skafreen2225-ctrl/Smart-Plant-Monitoring-and-Watering-System/README.md

# Smart-Plant-Monitoring-and-Watering-System
ESP32-based Smart Plant Monitoring & Watering System with Automated Irrigation, IoT Monitoring, PCB Design, and CAD Enclosure Design.

## Overview

The Smart Plant Monitoring & Watering System is an ESP32-based IoT solution designed to automate plant care while providing environmental monitoring and interactive user engagement. The system continuously monitors soil moisture, temperature, humidity, and water tank level, automatically watering the plant when required and alerting the user when the water reservoir is low.

In addition to automation, the project incorporates interactive OLED expressions that respond to touch and proximity detection, creating a more engaging user experience. The project also includes a custom PCB designed using EasyEDA and a complete product enclosure designed using Onshape.

## Features

* Automatic plant watering using soil moisture monitoring
* Water tank level monitoring using an ultrasonic sensor
* Low-water buzzer alert system
* Temperature and humidity monitoring using DHT11
* OLED dashboard displaying real-time sensor readings
* Interactive OLED eye expressions
* Touch-based expression changes
* IR-based proximity detection
* IoT monitoring through Blynk
* Custom PCB design using EasyEDA
* Custom enclosure design using Onshape

## Components Used

* ESP32 Development Board
* Soil Moisture Sensor
* DHT11 Temperature and Humidity Sensor
* HC-SR04 Ultrasonic Sensor
* SSD1306 OLED Display
* IR Proximity Sensor
* Touch Sensor
* Relay Module
* Water Pump
* Buzzer
* Logic Level Converter
* Water Reservoir
* Power Supply

## Tools Used
* ESP32
* Arduino IDE
* EasyEDA
* Onshape
* Blynk IoT

## Software and Design Tools

* Arduino IDE
* Blynk IoT Platform
* EasyEDA
* Onshape

## Repository Structure

* Documentation – Project report and supporting documents
* Source_Code – Arduino and Blynk implementations
* PCB_Design – Schematic, PCB layout, 3D view, and Gerber files
* CAD_Design – Enclosure and assembly designs
* Images – Circuit diagrams, PCB screenshots, and CAD renders
* Videos – Demonstration video links

## Future Improvements

* Mobile push notifications
* Solar-powered operation
* AI-based plant health recommendations
* Support for multiple plants
* Battery backup system
