skafreen2225-ctrl/Smart-Plant-Monitoring-and-Watering-System/CAD_Design/Complete_Enclosure .png

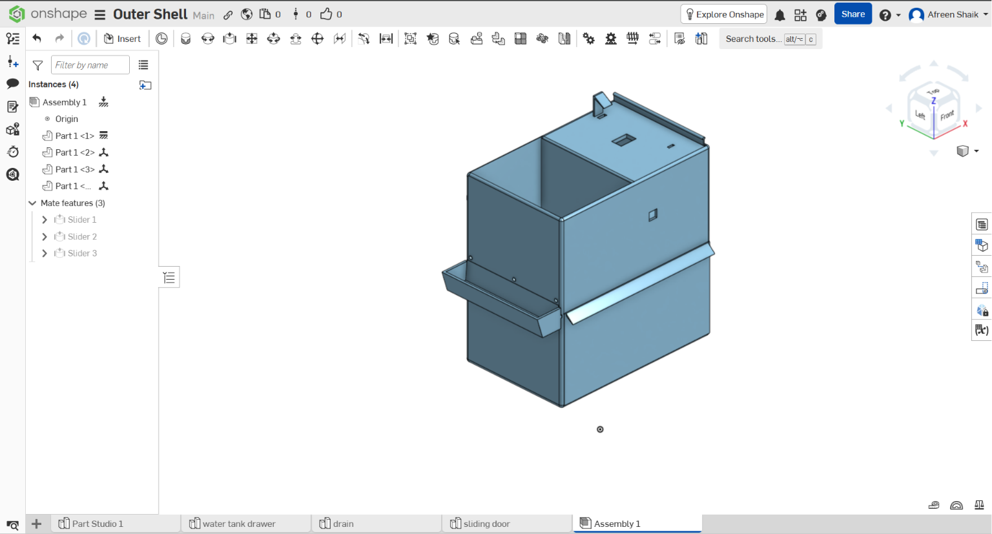
CAD_Design/Complete_Enclosure .png
