skafreen2225-ctrl/Smart-Plant-Monitoring-and-Watering-System/CAD_Design/Drain_Slot_Action.png

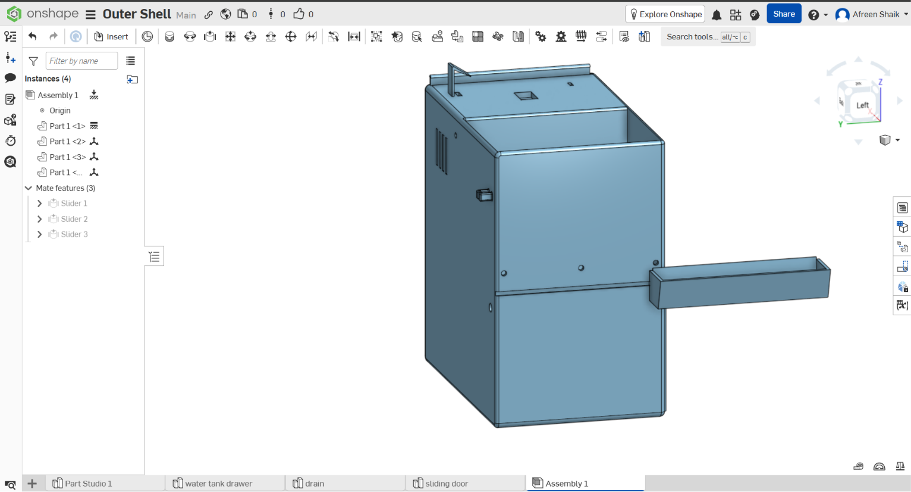
CAD_Design/Drain_Slot_Action.png
