skafreen2225-ctrl/Smart-Plant-Monitoring-and-Watering-System/CAD_Design/Sliding_Door_Action.png

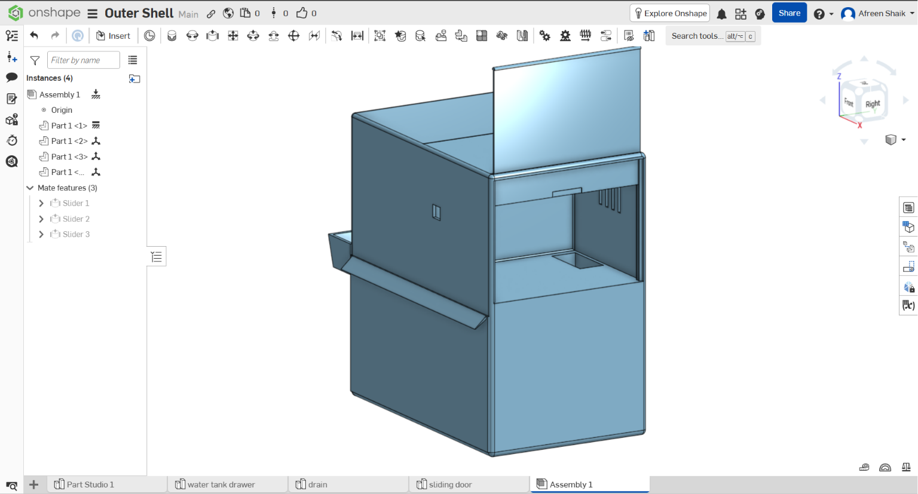
CAD_Design/Sliding_Door_Action.png
