skafreen2225-ctrl/Smart-Plant-Monitoring-and-Watering-System/CAD_Design/Water_Tank_Drawer.png

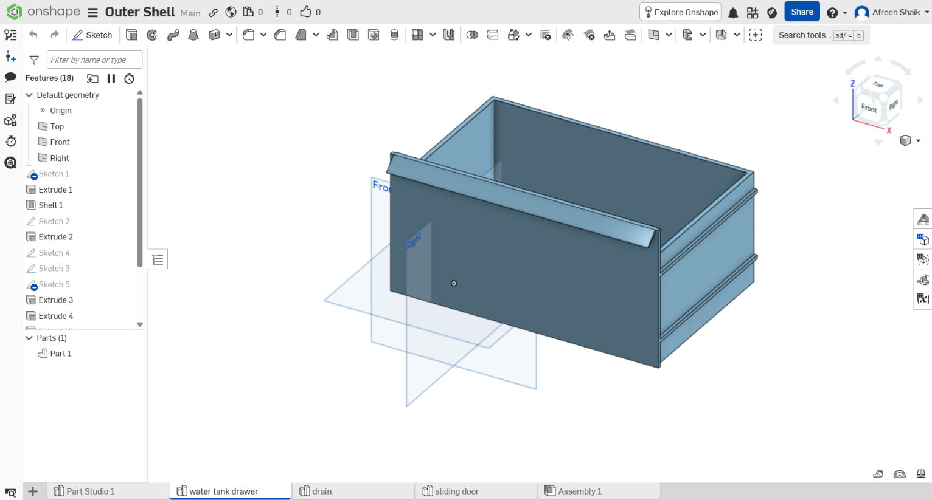
CAD_Design/Water_Tank_Drawer.png
