skafreen2225-ctrl/Smart-Plant-Monitoring-and-Watering-System/PCB_Design/PCB_PCB_smart_plant_watering_system_Top_layer.png

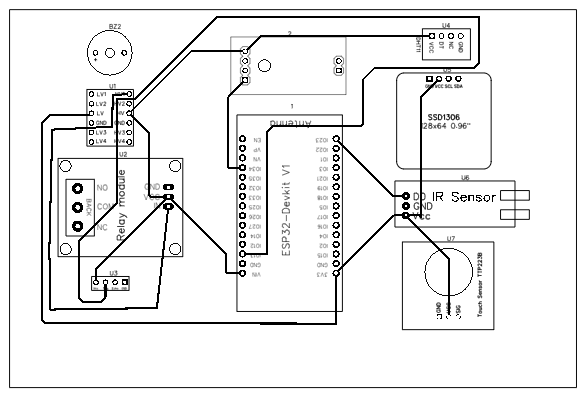
PCB_Design/PCB_PCB_smart_plant_watering_system_Top_layer.png
