skafreen2225-ctrl/Smart-Plant-Monitoring-and-Watering-System/PCB_Design/Schematic_smart_plant_watering.png

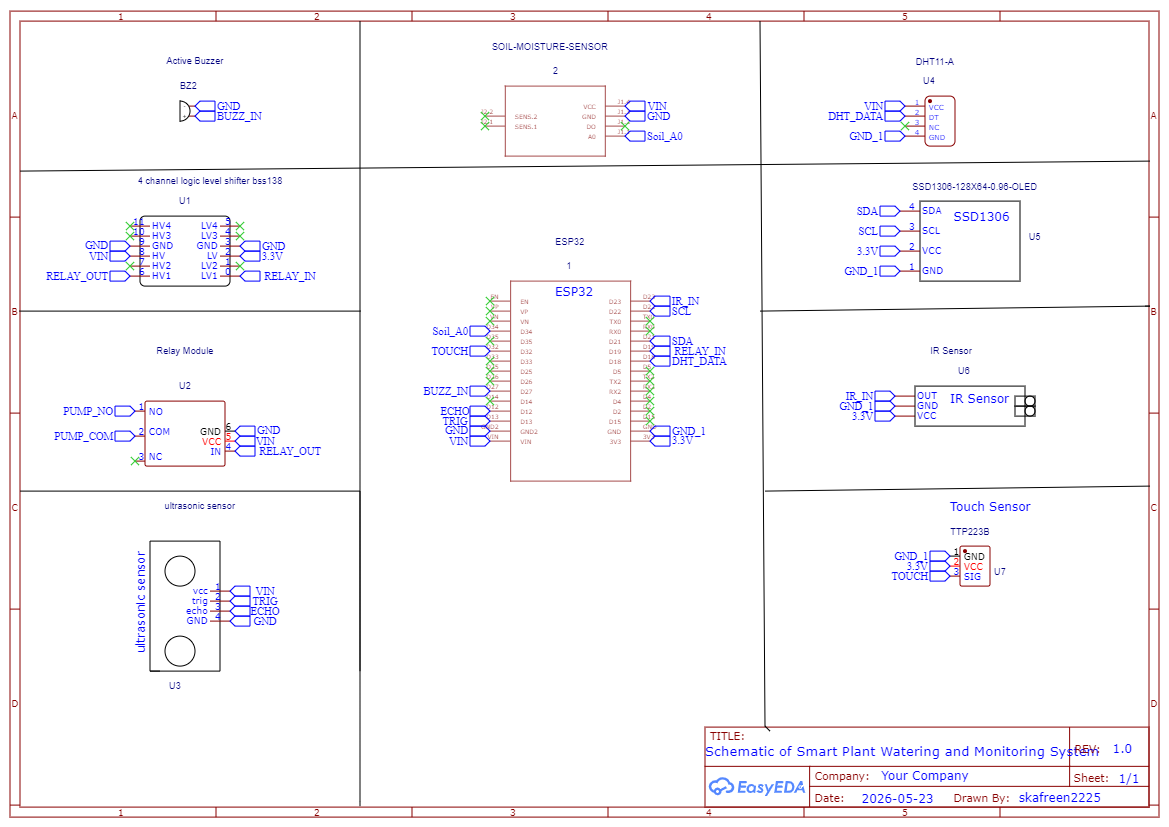
PCB_Design/Schematic_smart_plant_watering.png
