skafreen2225-ctrl/Smart-Plant-Monitoring-and-Watering-System/(commit log)

2026-06-09 Update and rename placeholder.txt to Arduino_Implementation.ino
2026-06-09 Update and rename placeholder.txt to Schematic_smart_plant_watering.png
2026-06-09 Create PCB_Design
